Rongbin99/ece298a-f25/docs/gds_results.md

# Synthesis warnings

* Warning: Replacing memory \registers with list of registers. See /home/runner/work/ece298a-f25/ece298a-f25/src/register_interface.v:49

# Routing stats

| Utilisation (%) | Wire length (um) |
|---|---|
| 54.539 % | 17407 |

# Cell usage by Category

| Category | Cells | Count |
|---|---|---|
|Fill | [decap](https://skywater-pdk.readthedocs.io/en/main/contents/libraries/sky130_fd_sc_hd/cells/decap/README.html) [fill](https://skywater-pdk.readthedocs.io/en/main/contents/libraries/sky130_fd_sc_hd/cells/fill/README.html) | 1050|
|Tap | [tapvpwrvgnd](https://skywater-pdk.readthedocs.io/en/main/contents/libraries/sky130_fd_sc_hd/cells/tapvpwrvgnd/README.html) | 225|
|Combo Logic | [and4bb](https://skywater-pdk.readthedocs.io/en/main/contents/libraries/sky130_fd_sc_hd/cells/and4bb/README.html) [and2b](https://skywater-pdk.readthedocs.io/en/main/contents/libraries/sky130_fd_sc_hd/cells/and2b/README.html) [a31o](https://skywater-pdk.readthedocs.io/en/main/contents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
|Flip Flops | [dfrtp](https://skywater-pdk.readthedocs.io/en/main/contents/libraries/sky130_fd_sc_hd/cells/dfrtp/README.html) [dfstp](https://skywater-pdk.readthedocs.io/en/main/contents/libraries/sky130_fd_sc_hd/cells/dfstp/README.html) | 129|
|Misc | [conb](https://skywater-pdk.readthedocs.io/en/main/contents/libraries/sky130_fd_sc_hd/cells/conb/README.html) [dlymetal6s2s](https://skywater-pdk.readthedocs.io/en/main/contents/libraries/sky130_fd_sc_hd/cells/dlymetal6s2s/README.html) [dlygate4sd3](https://skywater-pdk.readthedocs.io/en/main/contents/libraries/sky130_fd_sc_hd/cells/dlygate4sd3/README.html) | 104|
|NOR | [nor2](https://skywater-pdk.readthedocs.io/en/main/contents/libraries/sky130_fd_sc_hd/cells/nor2/README.html) [nor3](https://skywater-pdk.readthedocs.io/en/main/contents/libraries/sky130_fd_sc_hd/cells/nor3/README.html) [xnor2](https://skywater-pdk.readthedocs.io/en/main/contents/libraries/sky130_fd_sc_hd/cells/xnor2/README.html) | 89|
|Multiplexer | [mux2](https://skywater-pdk.readthedocs.io/en/main/contents/libraries/sky130_fd_sc_hd/cells/mux2/README.html) | 73|
|Buffer | [clkbuf](https://skywater-pdk.readthedocs.io/en/main/contents/libraries/sky130_fd_sc_hd/cells/clkbuf/README.html) [buf](https://skywater-pdk.readthedocs.io/en/main/contents/libraries/sky130_fd_sc_hd/cells/buf/README.html) [bufinv](https://skywater-pdk.readthedocs.io/en/main/contents/libraries/sky130_fd_sc_hd/cells/bufinv/README.html) | 72|
|OR | [or2](https://skywater-pdk.readthedocs.io/en/main/contents/libraries/sky130_fd_sc_hd/cells/or2/README.html) [xor2](https://skywater-pdk.readthedocs.io/en/main/contents/libraries/sky130_fd_sc_hd/cells/xor2/README.html) [or4](https://skywater-pdk.readthedocs.io/en/main/contents/libraries/sky130_fd_sc_hd/cells/or4/README.html) [or3](https://skywater-pdk.readthedocs.io/en/main/contents/libraries/sky130_fd_sc_hd/cells/or3/README.html) | 70|
|NAND | [nand2b](https://skywater-pdk.readthedocs.io/en/main/contents/libraries/sky130_fd_sc_hd/cells/nand2b/README.html) [nand2](https://skywater-pdk.readthedocs.io/en/main/contents/libraries/sky130_fd_sc_hd/cells/nand2/README.html) [nand3](https://skywater-pdk.readthedocs.io/en/main/contents/libraries/sky130_fd_sc_hd/cells/nand3/README.html) [nand4](https://skywater-pdk.readthedocs.io/en/main/contents/libraries/sky130_fd_sc_hd/cells/nand4/README.html) | 65|
|AND | [and2](https://skywater-pdk.readthedocs.io/en/main/contents/libraries/sky130_fd_sc_hd/cells/and2/README.html) [and4](https://skywater-pdk.readthedocs.io/en/main/contents/libraries/sky130_fd_sc_hd/cells/and4/README.html) [and3](https://skywater-pdk.readthedocs.io/en/main/contents/libraries/sky130_fd_sc_hd/cells/and3/README.html) [a21boi](https://skywater-pdk.readthedocs.io/en/main/contents/libraries/sky130_fd_sc_hd/cells/a21boi/README.html) | 45|
|Inverter | [inv](https://skywater-pdk.readthedocs.io/en/main/contents/libraries/sky130_fd_sc_hd/cells/inv/README.html) | 32|
|Clock | [clkinv](https://skywater-pdk.readthedocs.io/en/main/contents/libraries/sky130_fd_sc_hd/cells/clkinv/README.html) | 7|
|Diode | [diode](https://skywater-pdk.readthedocs.io/en/main/contents/libraries/sky130_fd_sc_hd/cells/diode/README.html) | 3|
## 868 total cells (excluding fill and tap cells)

14 passed

# Tiny Tapeout Precheck Results

| Check | Result |
|---|---|
| Magic DRC | ✅ |
| KLayout FEOL | ✅ |
| KLayout BEOL | ✅ |
| KLayout offgrid | ✅ |
| KLayout pin label overlapping drawing | ✅ |
| KLayout zero area | ✅ |
| KLayout Checks | ✅ |
| Pin check | ✅ |
| Boundary check | ✅ |
| Power pin check | ✅ |
| Layer check | ✅ |
| Cell name check | ✅ |
| urpm/nwell check | ✅ |
| Analog pin check | ✅ |

In case of failure, please reach out on [discord](https://tinytapeout.com/discord) for assistance.
