Rongbin99/ece298a-f25/pmod-sim/tt-audio-pmod.kicad_sch

## KiCad design pmod-sim/tt-audio-pmod.kicad_sch (2025-11-14)

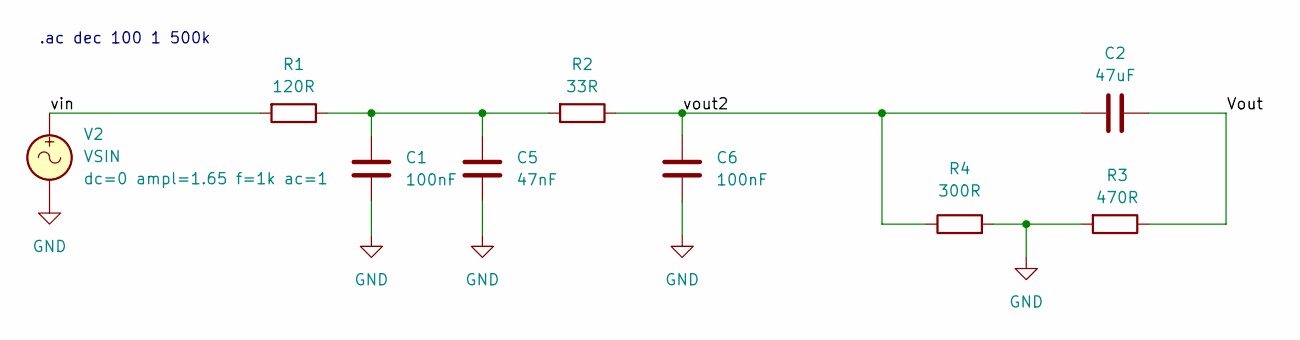
[picture p6: schematic tt-audio-pmod.kicad_sch]

Parts:
C1, C6: 100nF; C_0603_1608Metric; LCSC Part C14663
C2: 47uF; C_0805_2012Metric; LCSC Part C16780
C5: 47nF; C_0603_1608Metric; LCSC Part C1622
R1: 120R; R_0603_1608Metric; LCSC Part C22787
R2: 33R; R_0603_1608Metric; LCSC Part C23140
R3: 470R; R_0603_1608Metric; LCSC Part C23179
R4: 300R
V2: VSIN

Connections:
GND: C1.2, C5.2, C6.2, R3.2, R4.2, V2.2
unnamed: C1.1, C5.1, R1.1, R2.2
Vout: C2.1, R3.1
vin: R1.2, V2.1
vout2: C2.2, C6.1, R2.1, R4.1

Notes on the sheet:
.ac dec 100 1 500k
