Rongbin99/ece298a-f25/test/audio_util.py

HALF_STEP_RATIO = pow(2, 1/12)

def calculate_step(freq_hz):
    sample_rate = 28160
    return round((freq_hz * (2 ** 14)) / sample_rate)

# MIDI note numbers
#       -1  0   1   2   3   4   5   6   7   8   9
# C     0   12  24  36  48  60  72  84  96  108 120
# C#    1   13  25  37  49  61  73  85  97  109 121
# D     2   14  26  38  50  62  74  86  98  110 122
# D#    3   15  27  39  51  63  75  87  99  111 123
# E     4   16  28  40  52  64  76  88  100 112 124
# F     5   17  29  41  53  65  77  89  101 113 125
# F#    6   18  30  42  54  66  78  90  102 114 126
# G     7   19  31  43  55  67  79  91  103 115 127
# G#    8   20  32  44  56  68  80  92  104 116
# A     9   21  33  45  57  69  81  93  105 117
# A#    10  22  34  46  58  70  82  94  106 118
# B     11  23  35  47  59  71  83  95  107 119

def tostep(note):
    A4_FREQ = 440.0
    A4_MIDI = 69
    midi_number = note
    freq = A4_FREQ * (HALF_STEP_RATIO ** (midi_number - A4_MIDI))
    return calculate_step(freq)
