Rongbin99/ece298a-f25/(commit log)

2025-09-23 Update info.md with hardware and pin assignment details
    Added details about external hardware and pin assignments.
2025-10-26 add files and initial pwm impl
2025-10-28 fix error in pwm.v
    [pwm.v]
2025-10-28 I FIXED THE SINE WAVE
    [sine.v, sine_test.py]
2025-11-12 trying things
    [tt-audio-pmod.kicad_sch]
2025-11-14 hella audio testing
    [freq_response.csv, tt-audio-pmod.kicad_sch]
2025-11-17 add edge case, reset, and overflow stress tests
    [pwm_phase_test.py, regs_test.py, triangle_test.py]
